myratmyradov1997/dowel-desk-shelf/source/README.md

# Sources

## Fusion 360 scripts (`fusion/`)

Everything is generated by Fusion 360 API scripts (Python). Run them from *Utilities → Add-Ins → Scripts*.
Before running, change the `OUT` path at the top of each script (it points to the author's machine as `/Users/YOU/...`).

| Script | Builds |
|---|---|
| `deskshelf_v2_4c.py` | The whole shelf: legs, tiles, drawers, clips, gauge, test coupons, interference and drawer-travel checks, STL/STEP/F3D export. Parameters at the top: rod positions `YS`, end-leg socket `R`, inner sockets `SOCK_INNER`, clip bore `CLIP_RI`, drawer and channel sizes. Without an open `balka` document the rods are built as D20 × 1100 cylinders. |
| `deskshelf_v2_5c.py` | **Current.** As v2.4c, plus wrap-around deck tiles (v2.5, experimental) and the drawer stop tongue rooted in the floor (v2.5c, `TG_*` parameters). |
| `print_ready_v2_4c.py`, `print_ready_v2_5c.py` | Turn the exported STL into print orientation (plain Python + numpy). |
| `deskshelf_modules_v2.py`, `deskshelf_modules_v2_on_v2_3.py`, `print_ready_modules_v2.py` | MacBook dock, bookend, Mac mini stand. |
| `magsafe_mount_v3.py`, `magsafe_v3_print_ready.py` | MagSafe mount with printed M8 screw. |
| `accessories/*` | Gridfinity, front-rod holders, storage, backlight. They import an assembly `.f3d` (see `SRC` at the top) — point it to a file in `../cad`. |

Coordinates (mm): x along the rods (−550…550), y front (−) to back (+), z up from the desk; rod axes at z = 105, y = −100/−50/0/50/100.

## OrcaSlicer (`orca/`)

`slice_plates.py PROFILE_DIR OUT_DIR plates.json` slices plates with the OrcaSlicer CLI using the flattened profiles
`abs_quality`, `abs_fast_020`, `abs_fast_028`, `abs_fast_028_tile` (FlyingBear Ghost 6, ABS). Import the JSON files into Orca or copy the values.
