myratmyradov1997/dowel-desk-shelf/images/all_in_one.png

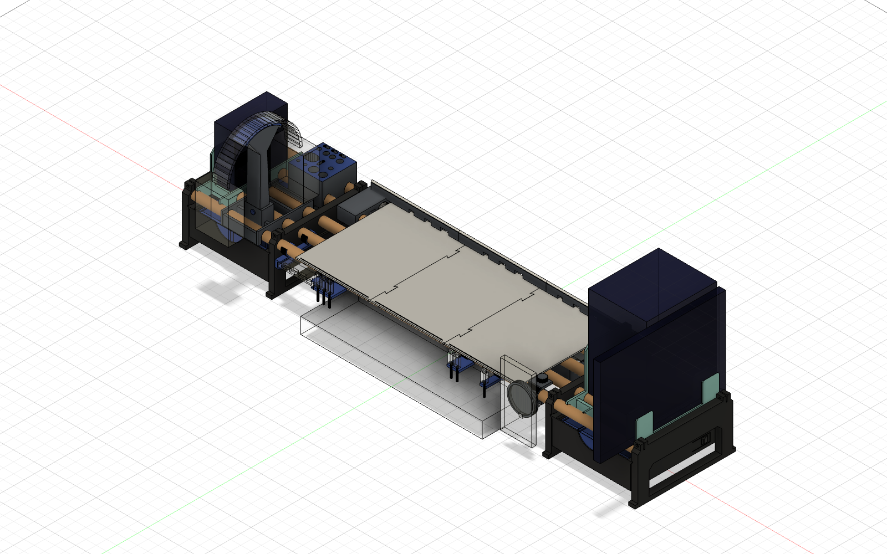
images/all_in_one.png
