myratmyradov1997/dowel-desk-shelf/images/shelf_closed.png

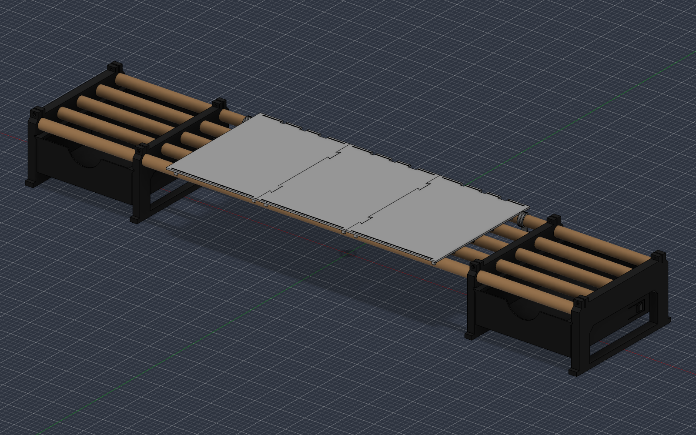
images/shelf_closed.png
