myratmyradov1997/dowel-desk-shelf/images/shelf_front.png

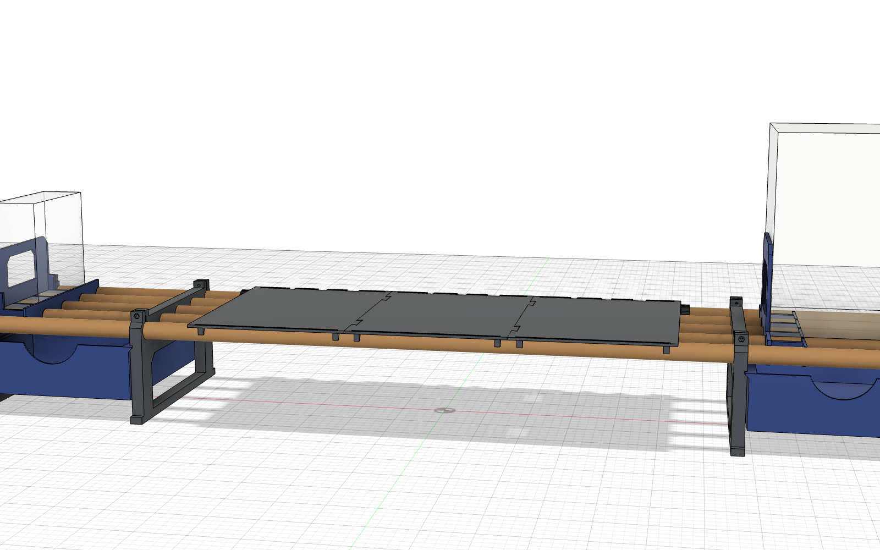
images/shelf_front.png
