myratmyradov1997/dowel-desk-shelf/cad/shelf_v2_5c_solids.step

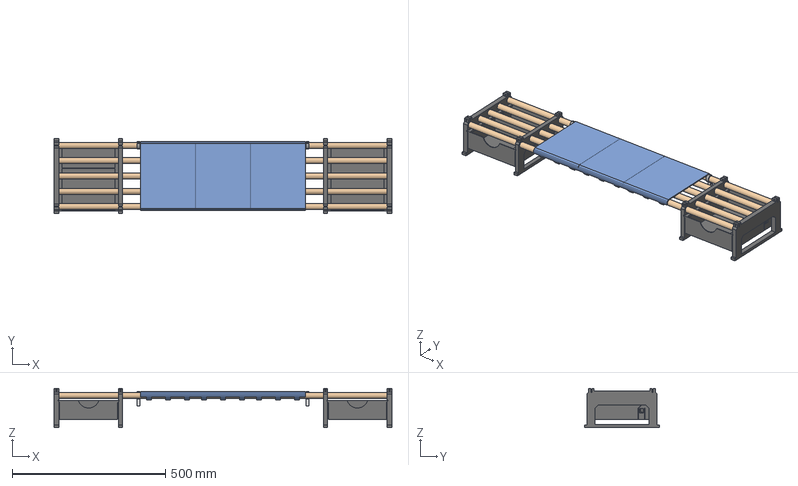
[picture p18: CAD file, 2026-10-23]
cad/shelf_v2_5c_solids.step
1104.0 x 244.0 x 128.0 mm
