myratmyradov1997/dowel-desk-shelf/stl/00-test-prints/fit_coupon_slide_drawer.stl

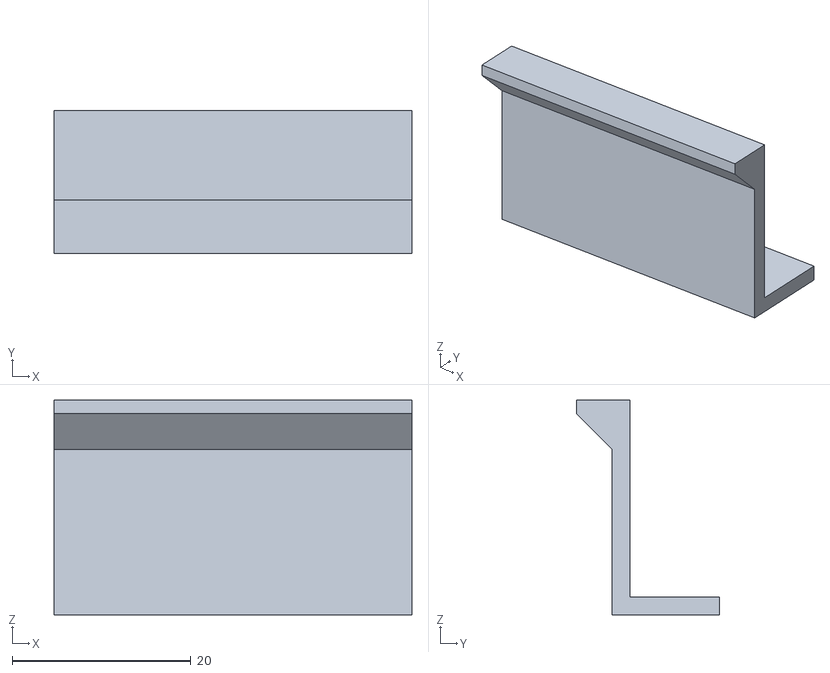
[picture p19: CAD file, 2026-10-20]
stl/00-test-prints/fit_coupon_slide_drawer.stl
40.0 x 16.0 x 24.0
