myratmyradov1997/dowel-desk-shelf/stl/01-shelf/drawer_left.stl

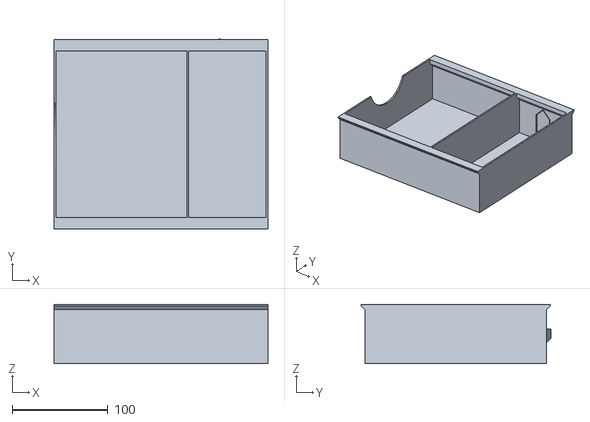
[picture p20: CAD file, 2026-10-23]
stl/01-shelf/drawer_left.stl
224.0 x 198.5 x 62.0
