myratmyradov1997/dowel-desk-shelf/stl/02-modules/bookend.stl

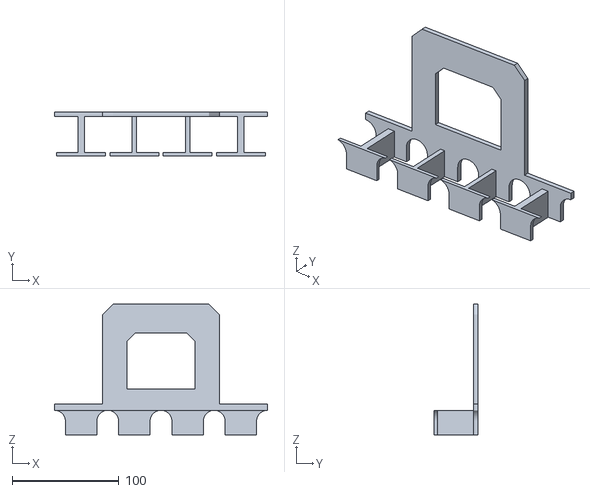
[picture p21: CAD file, 2026-10-20]
stl/02-modules/bookend.stl
200.0 x 41.0 x 123.0
