myratmyradov1997/dowel-desk-shelf/stl/03-magsafe/magsafe_mount_v3.stl

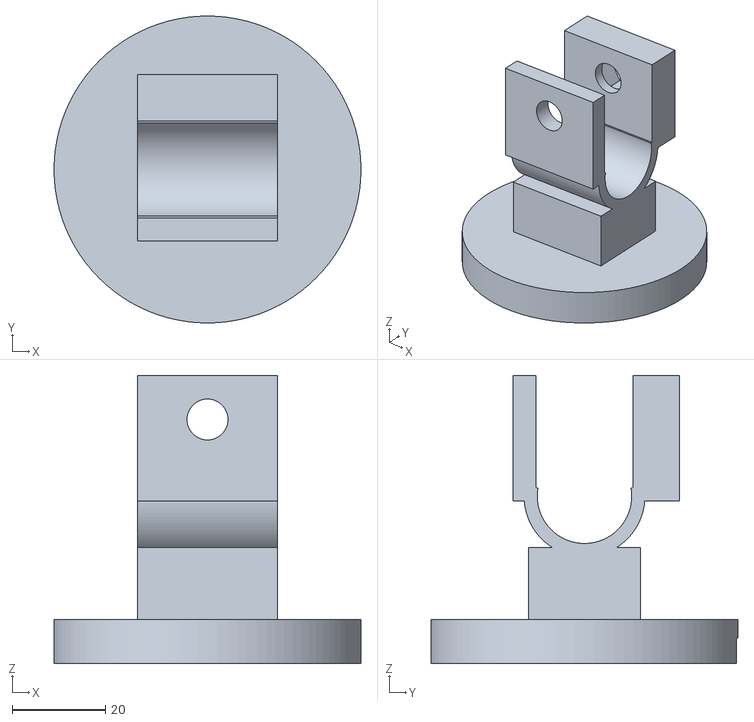
[picture p22: CAD file, 2026-10-20]
stl/03-magsafe/magsafe_mount_v3.stl
66.0 x 66.0 x 62.0
