myratmyradov1997/dowel-desk-shelf/stl/04-gridfinity/gf_bin_2x2_7u.stl

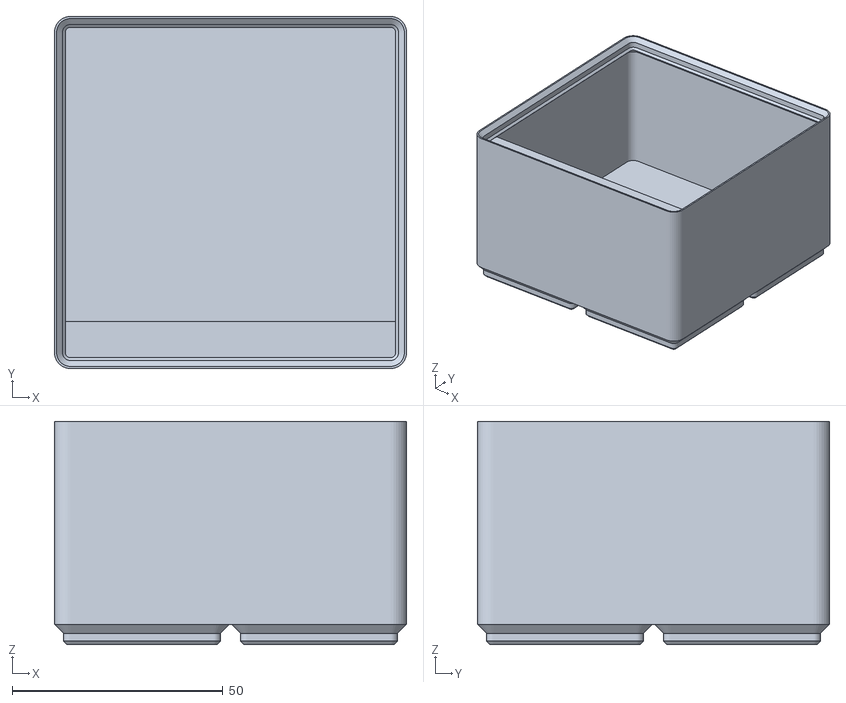
[picture p23: CAD file, 2026-10-20]
stl/04-gridfinity/gf_bin_2x2_7u.stl
83.5 x 83.5 x 52.9
