myratmyradov1997/dowel-desk-shelf/stl/06-storage/tool_rail.stl

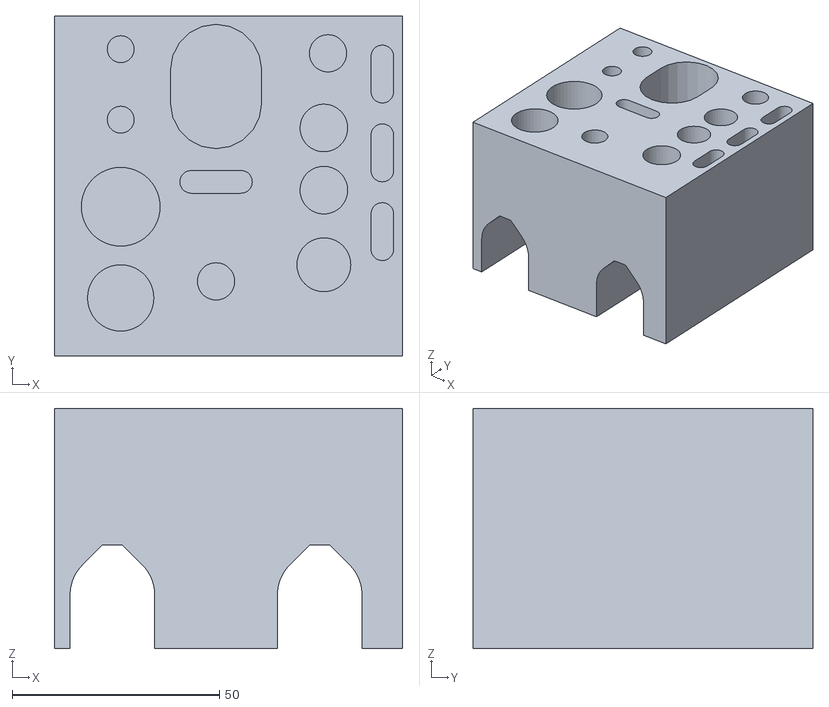
[picture p25: CAD file, 2026-10-20]
stl/06-storage/tool_rail.stl
84.0 x 82.0 x 58.0
