myratmyradov1997/dowel-desk-shelf/stl/07-backlight/acc_backlight_diffuser_S2.stl

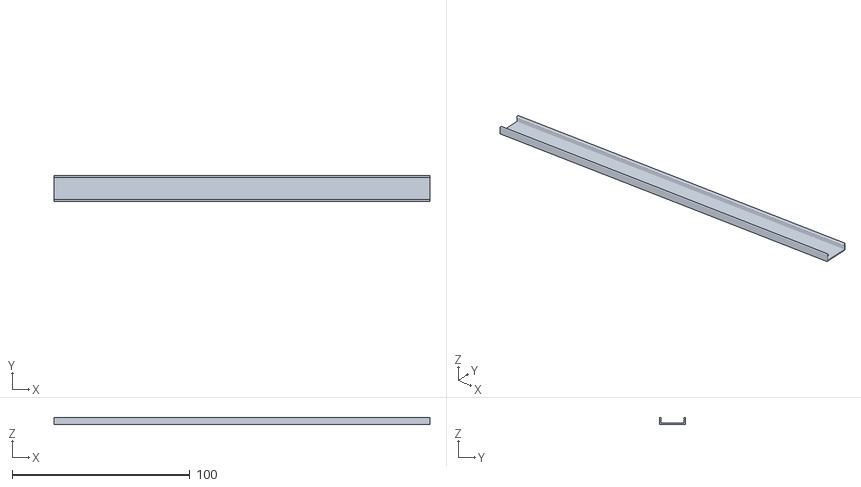
[picture p26: CAD file, 2026-10-20]
stl/07-backlight/acc_backlight_diffuser_S2.stl
211.8 x 14.9 x 4.05
