myratmyradov1997/dowel-desk-shelf/stl/00-test-prints/fit_coupon_slide_leg.stl

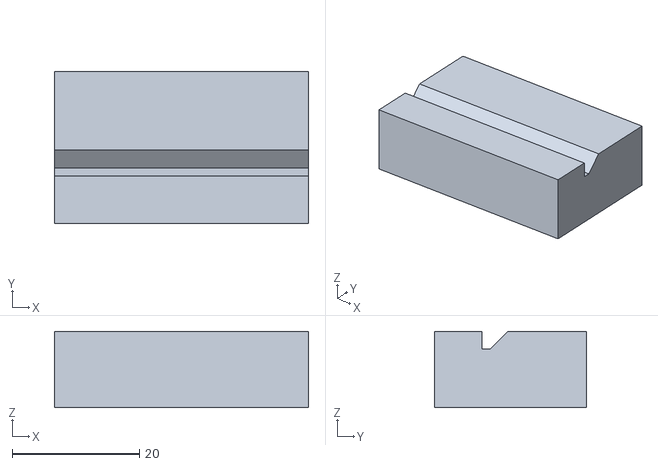
[picture p27: CAD file, 2026-10-20]
stl/00-test-prints/fit_coupon_slide_leg.stl
40.0 x 24.0 x 12.0
