myratmyradov1997/dowel-desk-shelf/stl/01-shelf/deck_tile_wrap_v2.5.stl

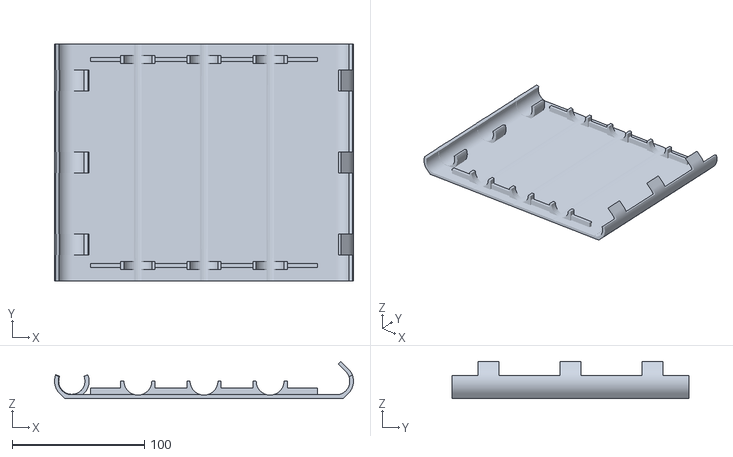
[picture p28: CAD file, 2026-10-23]
stl/01-shelf/deck_tile_wrap_v2.5.stl
226.2 x 179.5 x 28.0
