myratmyradov1997/dowel-desk-shelf/stl/02-modules/macmini_stand.stl

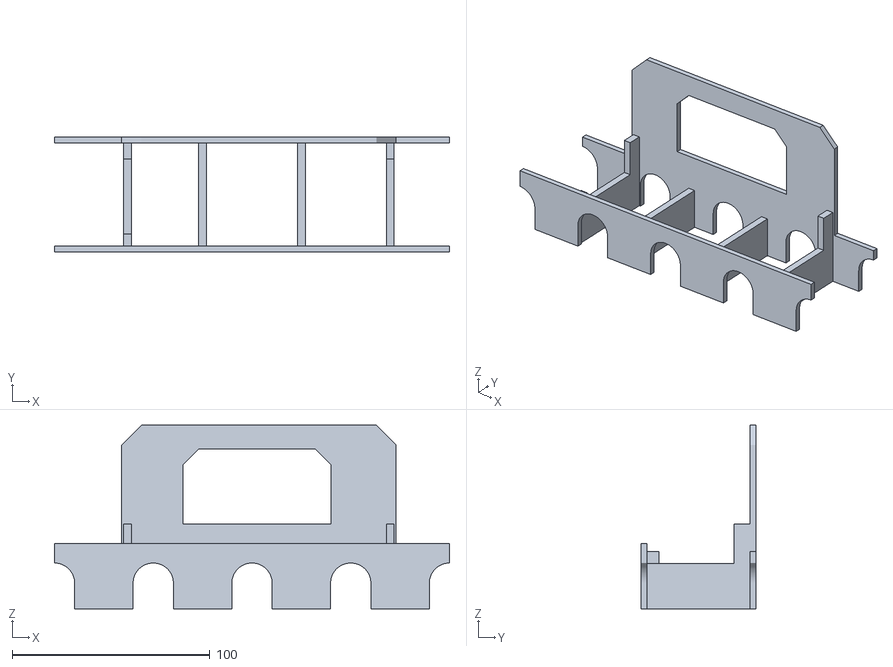
[picture p29: CAD file, 2026-10-20]
stl/02-modules/macmini_stand.stl
200.0 x 58.0 x 93.0
