myratmyradov1997/dowel-desk-shelf/stl/04-gridfinity/gf_bin_1x3_7u_dupont.stl

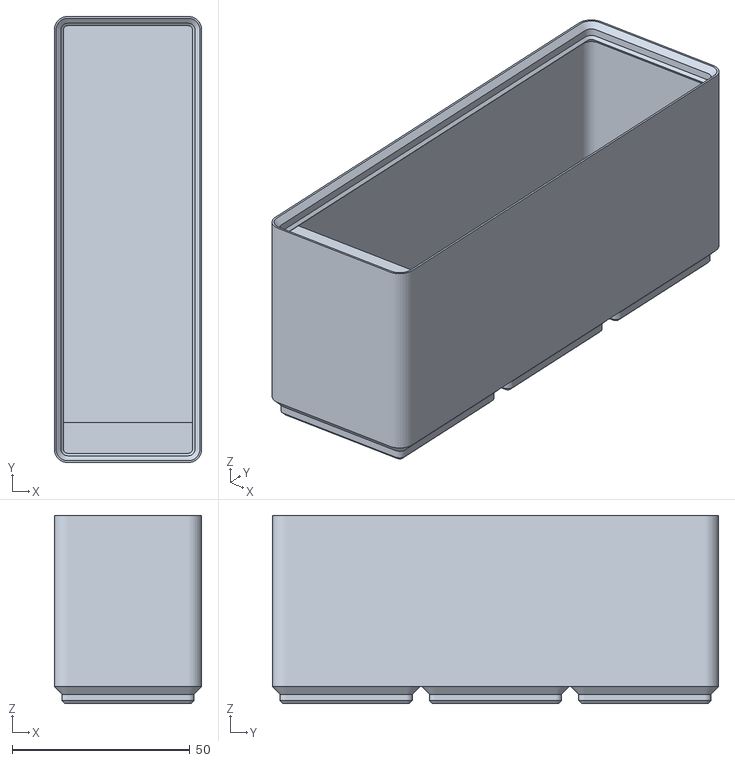
[picture p30: CAD file, 2026-10-20]
stl/04-gridfinity/gf_bin_1x3_7u_dupont.stl
41.5 x 125.5 x 52.9
