myratmyradov1997/dowel-desk-shelf/stl/05-front-rod/acc_cable_clip_2.stl

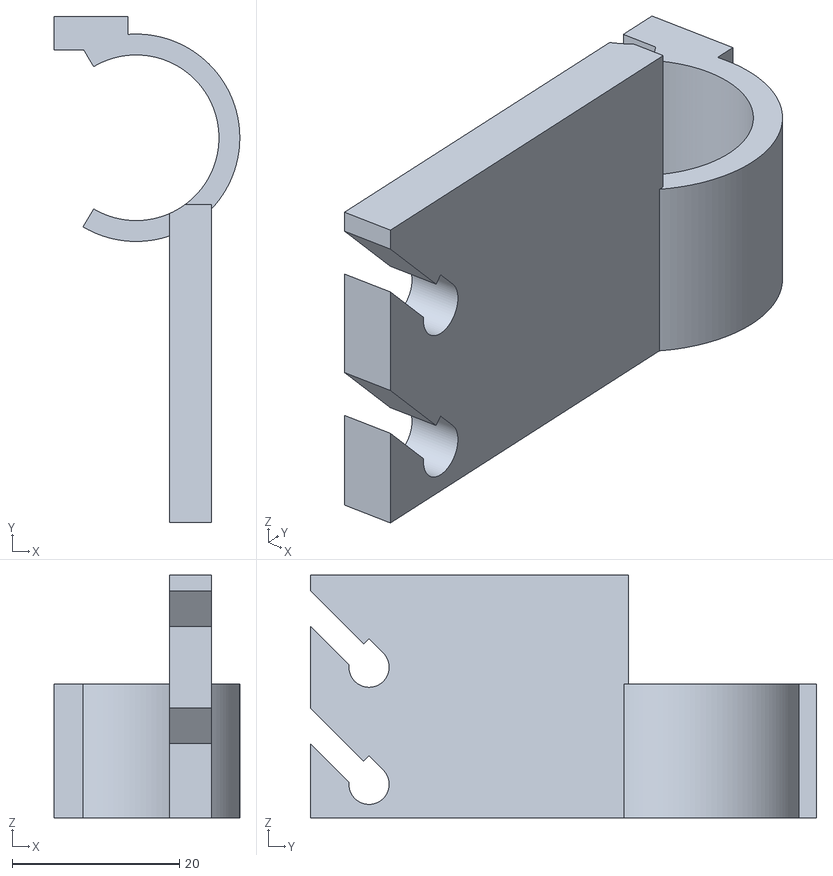
[picture p31: CAD file, 2026-10-20]
stl/05-front-rod/acc_cable_clip_2.stl
22.2 x 60.5 x 29.0
