myratmyradov1997/dowel-desk-shelf/stl/06-storage/tray_end_R.stl

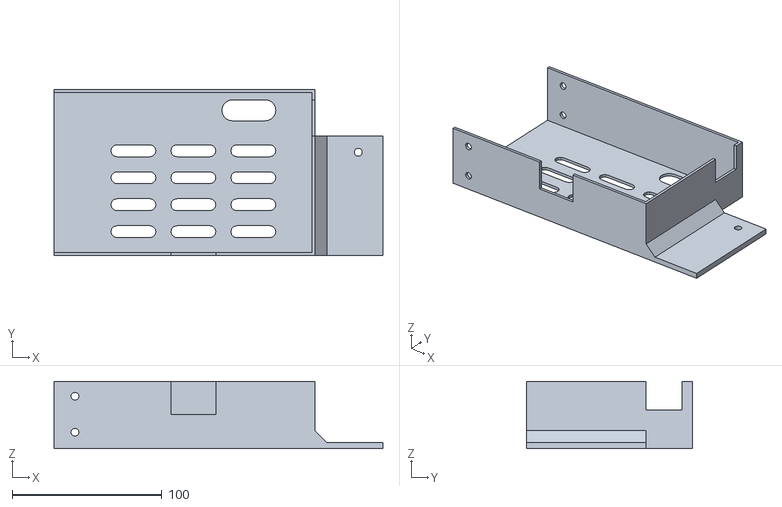
[picture p32: CAD file, 2026-10-20]
stl/06-storage/tray_end_R.stl
219.5 x 111.0 x 45.0
