myratmyradov1997/dowel-desk-shelf/stl/07-backlight/acc_backlight_box.stl

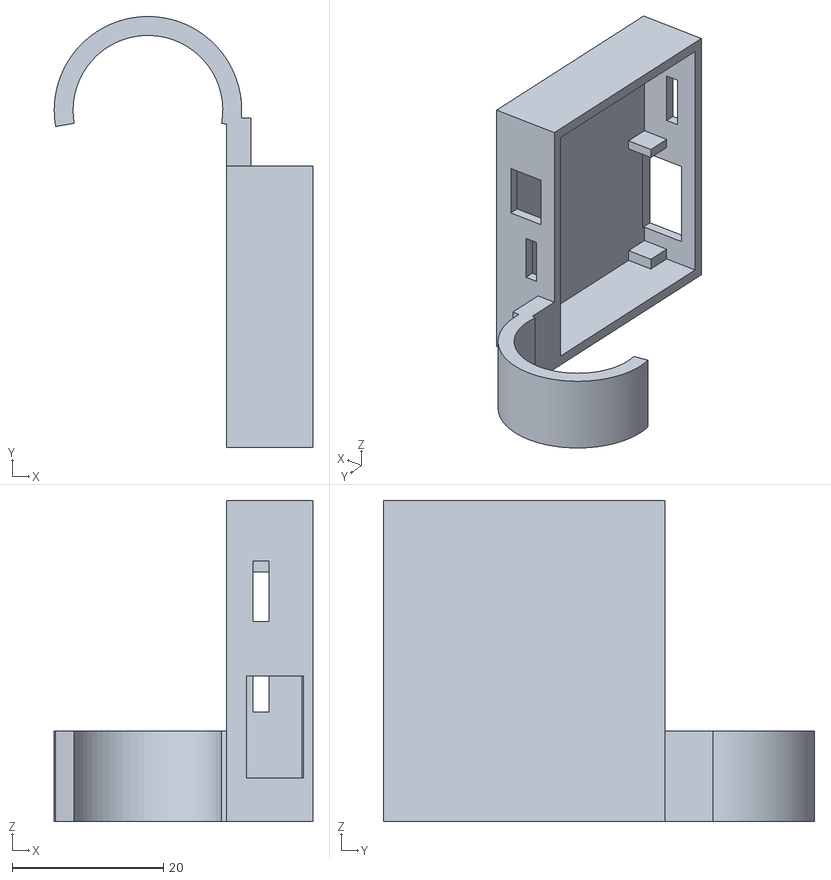
[picture p33: CAD file, 2026-10-20]
stl/07-backlight/acc_backlight_box.stl
34.2 x 57.0 x 42.5
