myratmyradov1997/dowel-desk-shelf/stl/00-test-prints/fit_coupon_sockets.stl

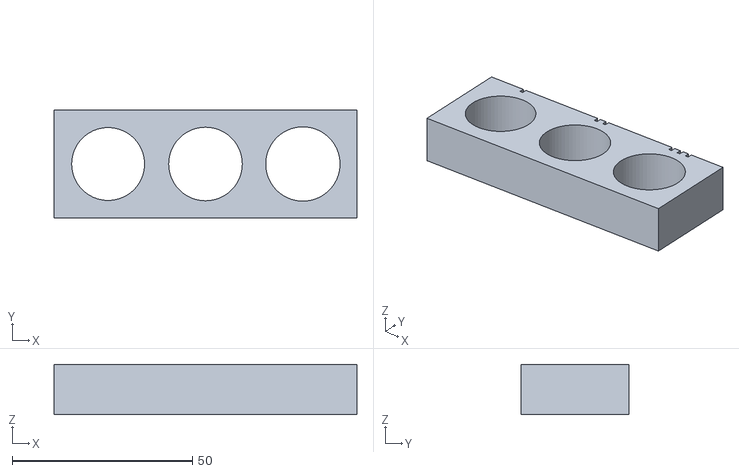
[picture p34: CAD file, 2026-10-20]
stl/00-test-prints/fit_coupon_sockets.stl
84.0 x 30.0 x 14.0
