myratmyradov1997/dowel-desk-shelf/stl/01-shelf/drawer_right.stl

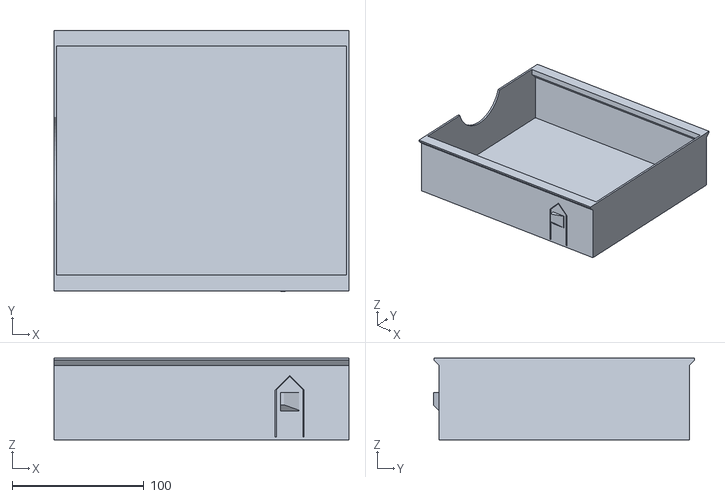
[picture p35: CAD file, 2026-10-23]
stl/01-shelf/drawer_right.stl
224.0 x 198.5 x 62.0
