myratmyradov1997/dowel-desk-shelf/stl/02-modules/laptop_dock.stl

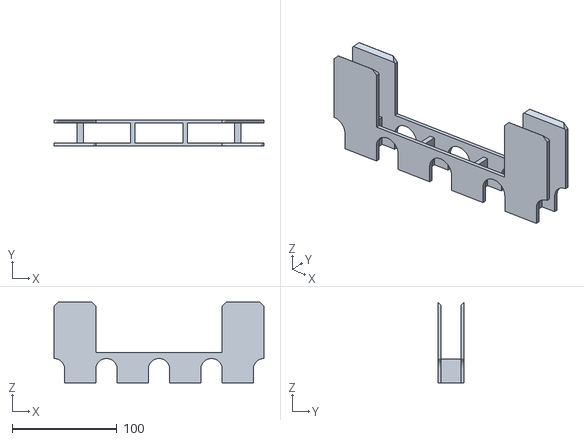
[picture p36: CAD file, 2026-10-20]
stl/02-modules/laptop_dock.stl
200.0 x 25.0 x 77.0
