myratmyradov1997/dowel-desk-shelf/stl/05-front-rod/acc_hub_cap_right.stl

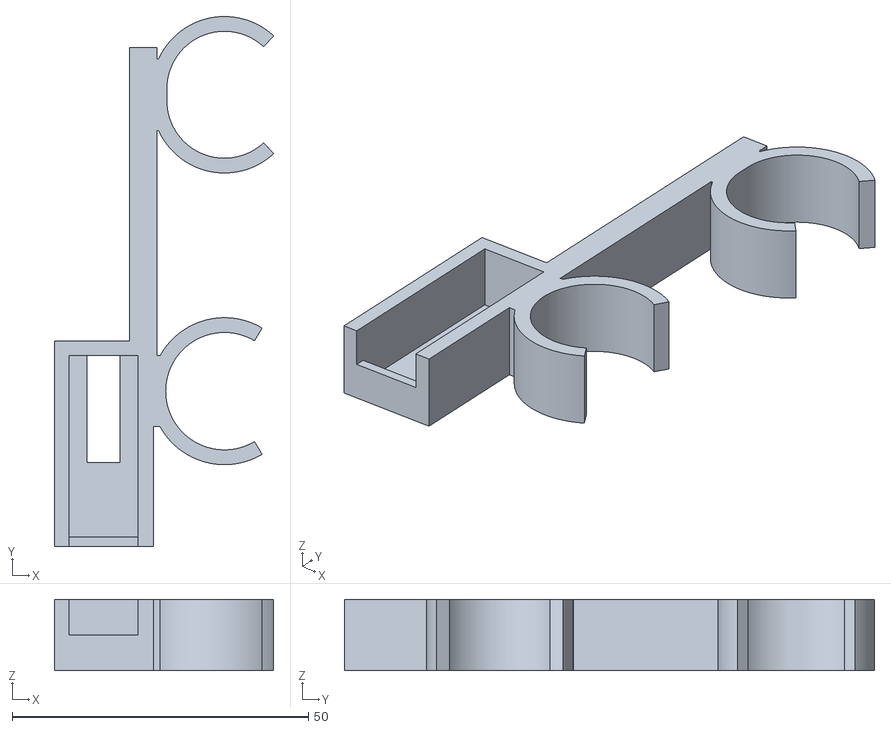
[picture p38: CAD file, 2026-10-20]
stl/05-front-rod/acc_hub_cap_right.stl
37.0 x 89.4 x 12.0
