myratmyradov1997/dowel-desk-shelf/stl/06-storage/tray_hanger_L.stl

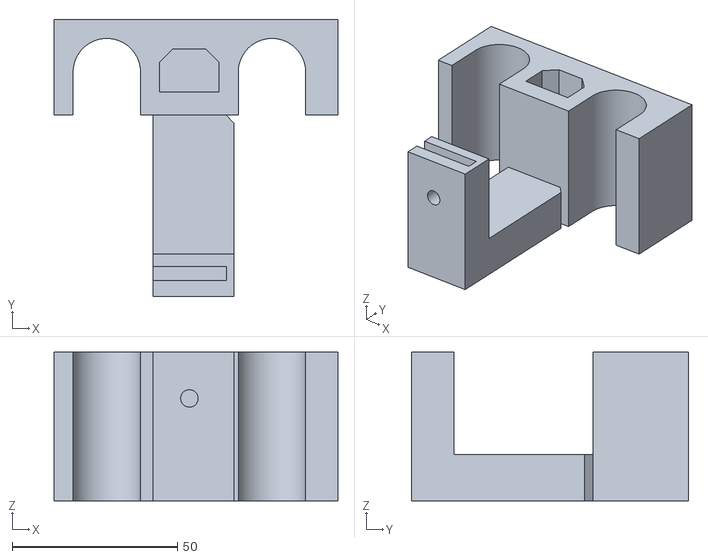
[picture p39: CAD file, 2026-10-20]
stl/06-storage/tray_hanger_L.stl
86.0 x 84.0 x 45.0
