myratmyradov1997/dowel-desk-shelf/stl/07-backlight/acc_backlight_rail_S1.stl

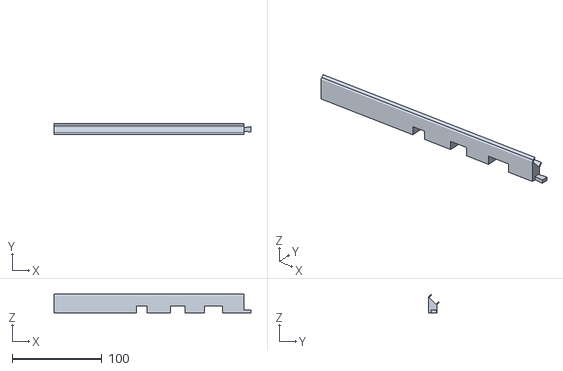
[picture p40: CAD file, 2026-10-20]
stl/07-backlight/acc_backlight_rail_S1.stl
219.9 x 12.0 x 20.8
