myratmyradov1997/dowel-desk-shelf/stl/01-shelf/leg_end_left_D20.4.stl

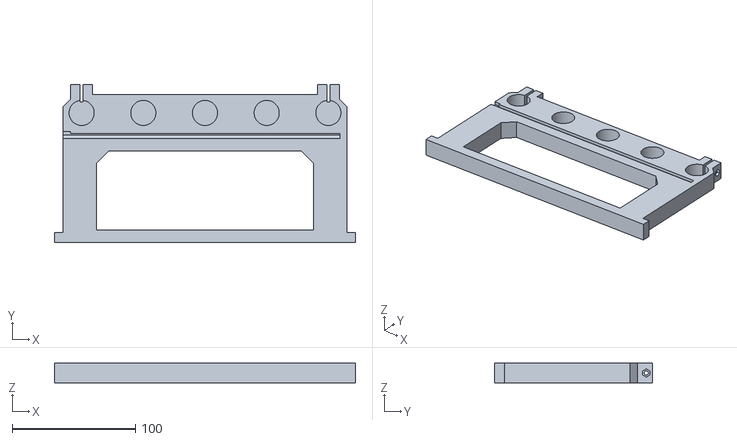
[picture p41: CAD file, 2026-10-20]
stl/01-shelf/leg_end_left_D20.4.stl
244.0 x 128.0 x 16.0
