myratmyradov1997/dowel-desk-shelf/stl/04-gridfinity/gf_plate_R_half_2x5.stl

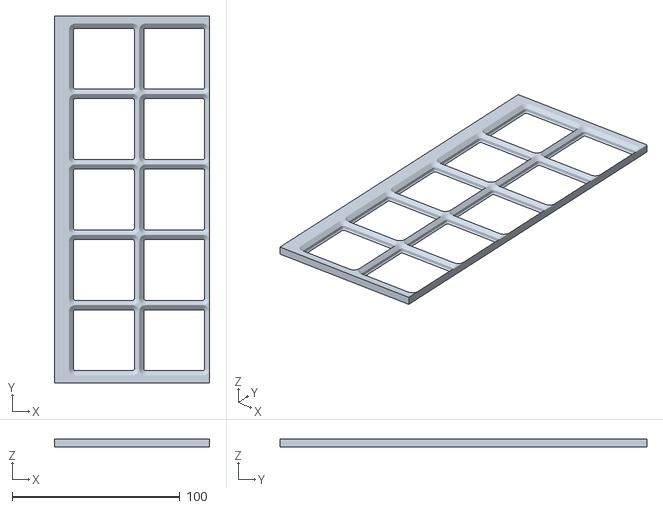
[picture p42: CAD file, 2026-10-20]
stl/04-gridfinity/gf_plate_R_half_2x5.stl
92.5 x 219.0 x 4.60
