myratmyradov1997/dowel-desk-shelf/stl/05-front-rod/acc_cable_clip_3.stl

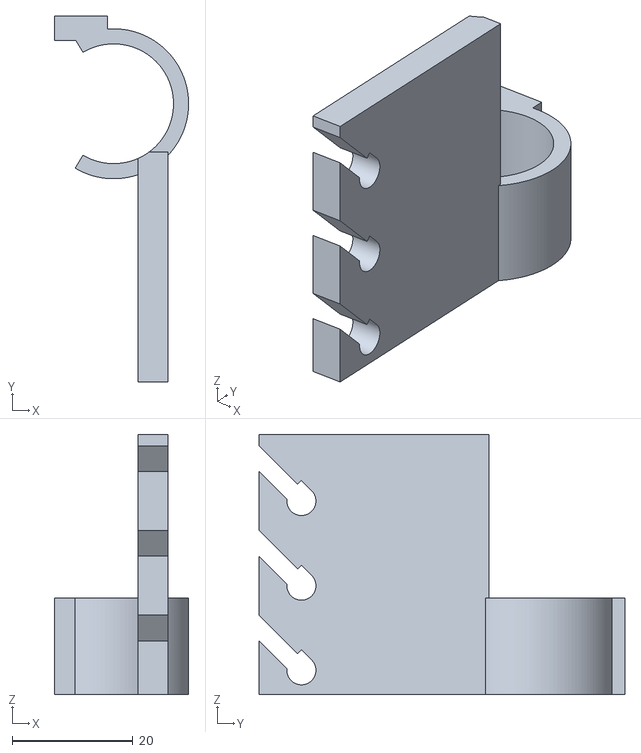
[picture p43: CAD file, 2026-10-20]
stl/05-front-rod/acc_cable_clip_3.stl
22.2 x 60.5 x 43.0
