myratmyradov1997/dowel-desk-shelf/stl/06-storage/hp_foot.stl

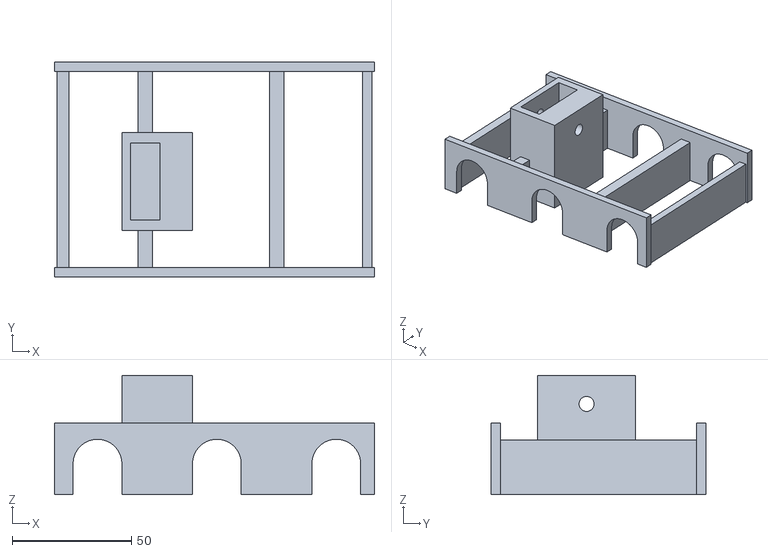
[picture p44: CAD file, 2026-10-20]
stl/06-storage/hp_foot.stl
134.0 x 90.0 x 50.0
