myratmyradov1997/dowel-desk-shelf/stl/04-gridfinity/gf_plate_Lback_half_2x1.stl

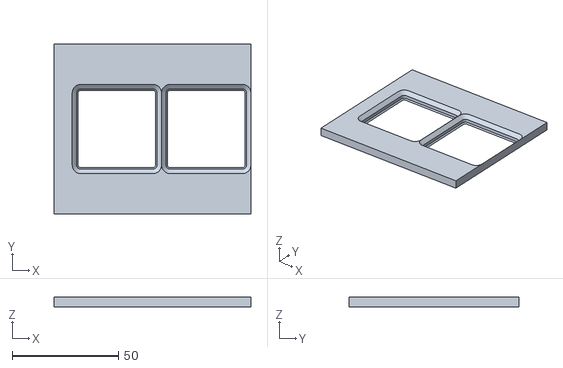
[picture p45: CAD file, 2026-10-20]
stl/04-gridfinity/gf_plate_Lback_half_2x1.stl
92.5 x 80.0 x 4.60
