myratmyradov1997/dowel-desk-shelf/stl/06-storage/hp_pin.stl

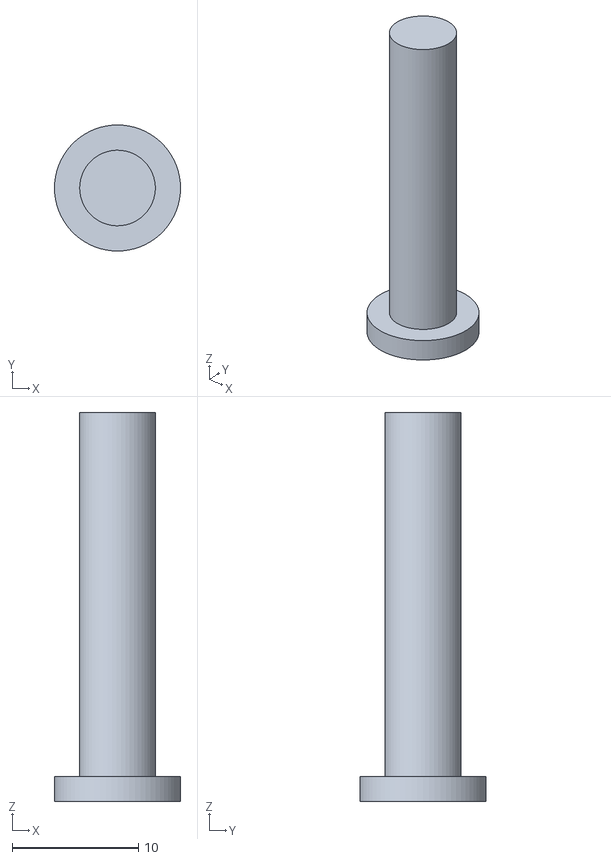
[picture p46: CAD file, 2026-10-20]
stl/06-storage/hp_pin.stl
10.0 x 10.0 x 30.8
