myratmyradov1997/dowel-desk-shelf/stl/07-backlight/acc_backlight_rail_S2.stl

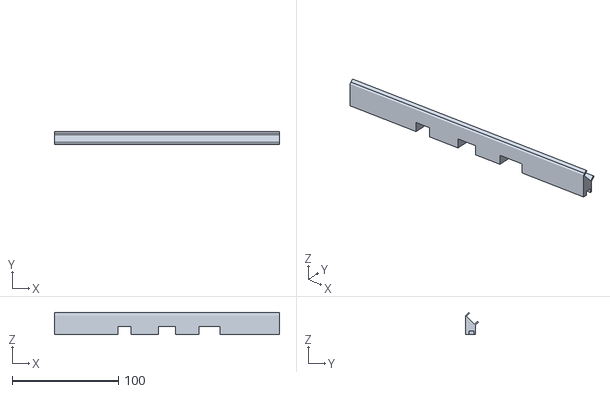
[picture p47: CAD file, 2026-10-20]
stl/07-backlight/acc_backlight_rail_S2.stl
211.8 x 12.0 x 20.8
