myratmyradov1997/dowel-desk-shelf/stl/04-gridfinity/gf_plate_Lfront_half_2x3.stl

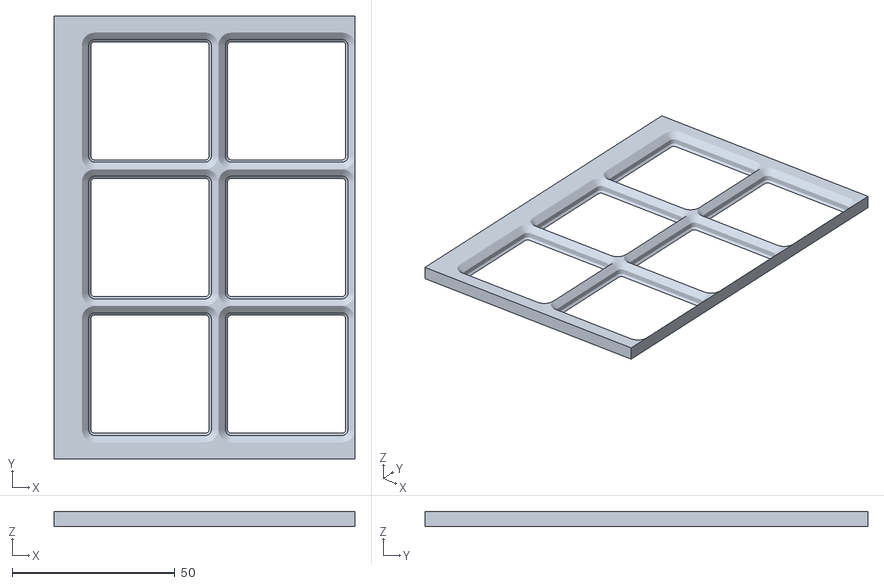
[picture p49: CAD file, 2026-10-20]
stl/04-gridfinity/gf_plate_Lfront_half_2x3.stl
92.5 x 136.0 x 4.60
