myratmyradov1997/dowel-desk-shelf/stl/07-backlight/acc_backlight_bracket_L.stl

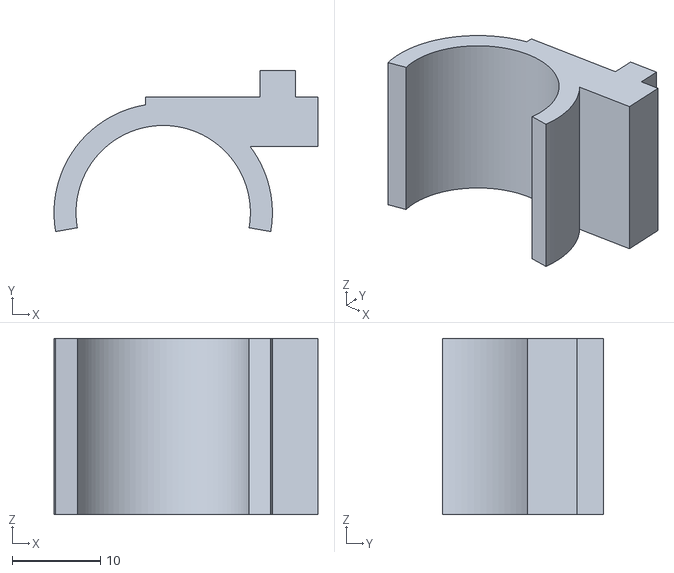
[picture p50: CAD file, 2026-10-20]
stl/07-backlight/acc_backlight_bracket_L.stl
30.0 x 18.3 x 20.0
