myratmyradov1997/dowel-desk-shelf/stl/01-shelf/deck_tile_2.stl

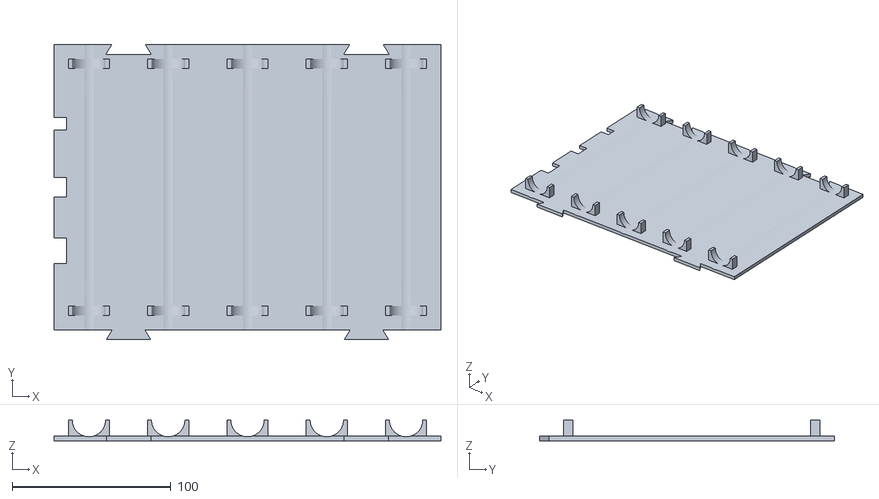
[picture p51: CAD file, 2026-10-20]
stl/01-shelf/deck_tile_2.stl
244.0 x 186.0 x 13.1
