myratmyradov1997/dowel-desk-shelf/stl/04-gridfinity/gf_bin_1x1_7u.stl

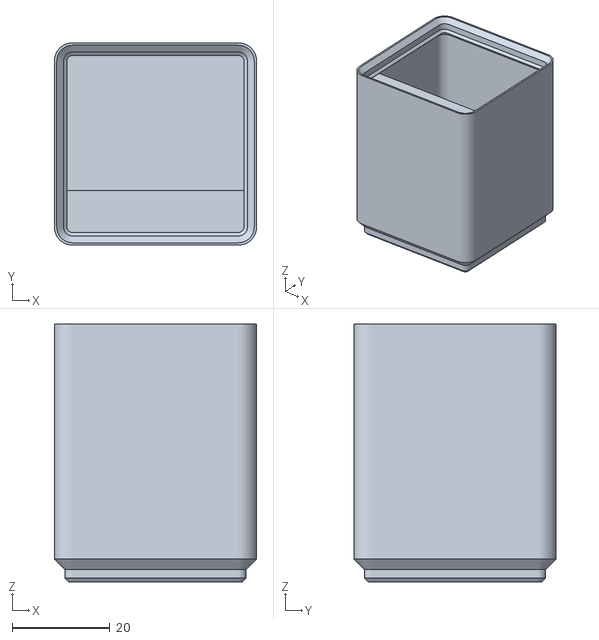
[picture p52: CAD file, 2026-10-20]
stl/04-gridfinity/gf_bin_1x1_7u.stl
41.5 x 41.5 x 52.9
