myratmyradov1997/dowel-desk-shelf/stl/06-storage/tray_lock_pin.stl

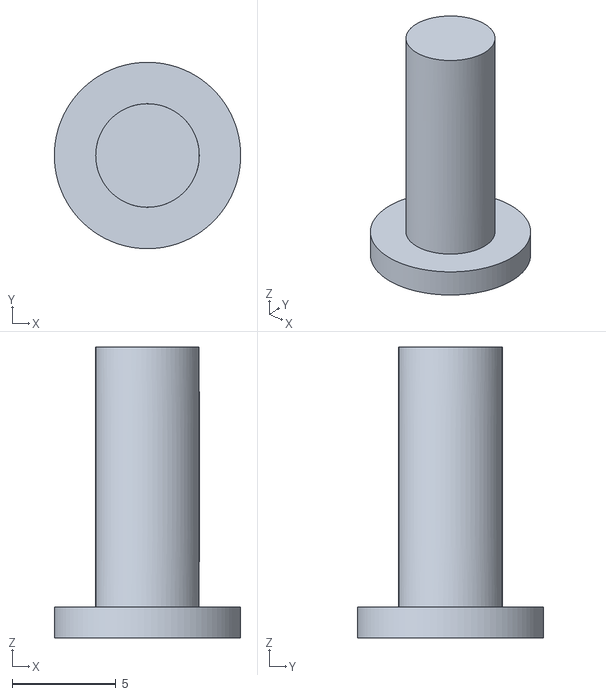
[picture p53: CAD file, 2026-10-20]
stl/06-storage/tray_lock_pin.stl
9.00 x 8.99 x 14.0
