myratmyradov1997/dowel-desk-shelf/stl/07-backlight/acc_backlight_box_lid.stl

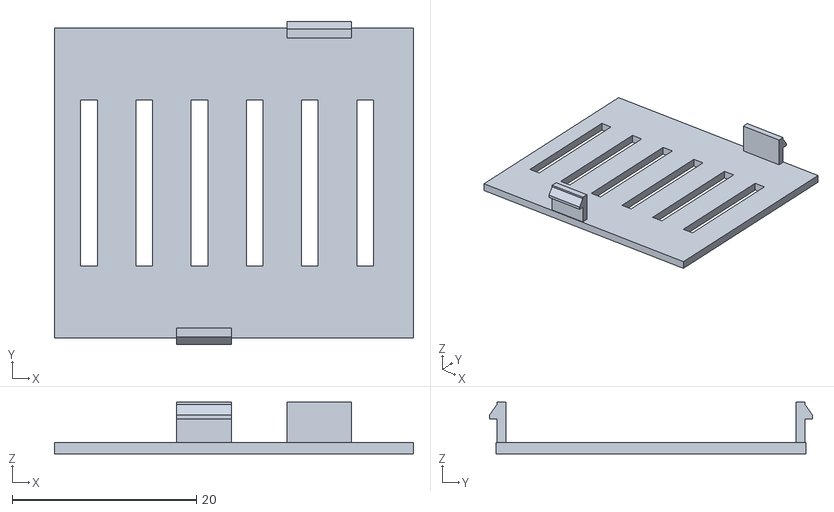
[picture p54: CAD file, 2026-10-20]
stl/07-backlight/acc_backlight_box_lid.stl
39.0 x 35.1 x 5.60
