myratmyradov1997/dowel-desk-shelf/stl/01-shelf/bay_gauge.stl

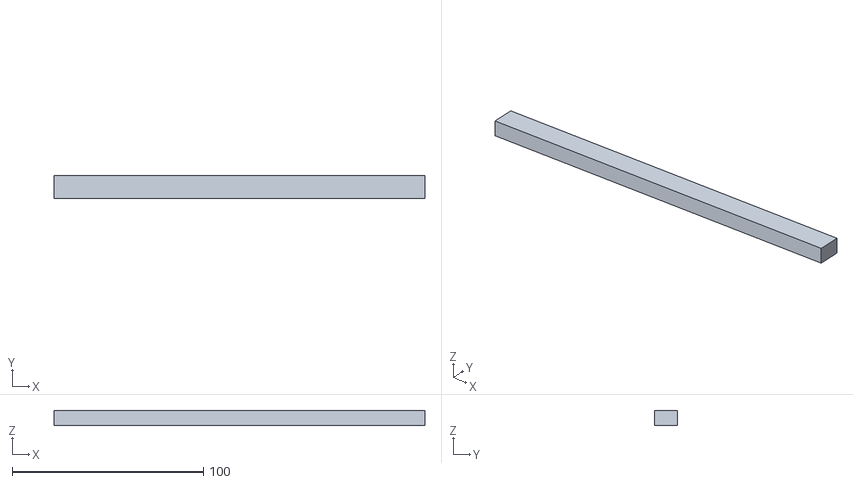
[picture p55: CAD file, 2026-10-20]
stl/01-shelf/bay_gauge.stl
194.0 x 12.0 x 8.00
