myratmyradov1997/dowel-desk-shelf/stl/07-backlight/acc_backlight_bracket_R.stl

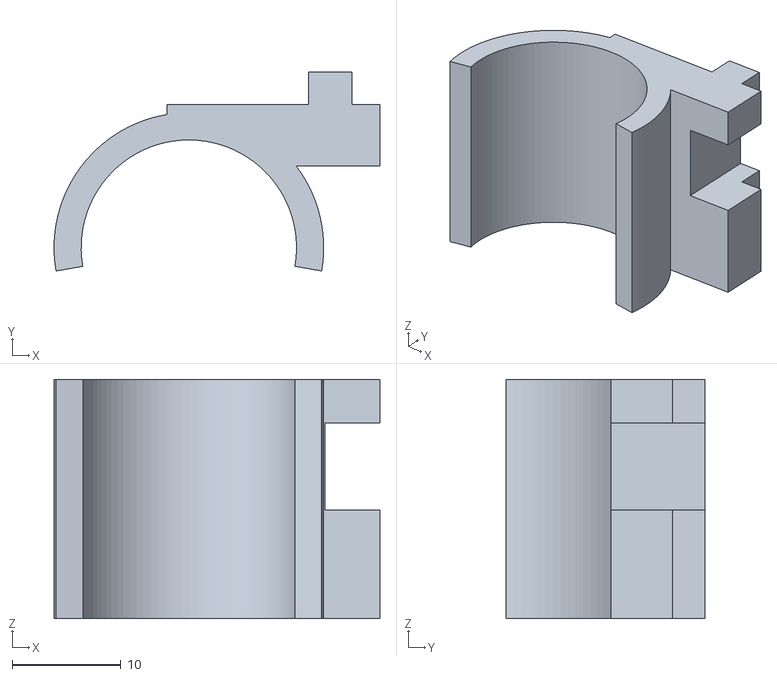
[picture p56: CAD file, 2026-10-20]
stl/07-backlight/acc_backlight_bracket_R.stl
30.0 x 18.3 x 22.0
