myratmyradov1997/dowel-desk-shelf/stl/06-storage/hp_post.stl

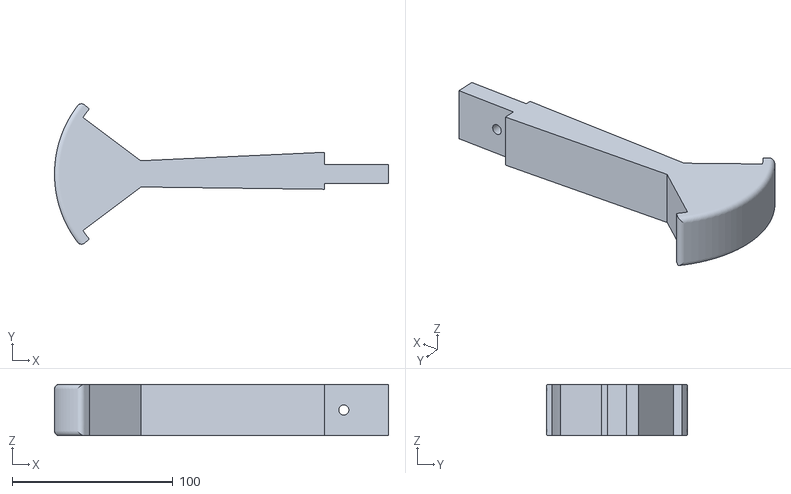
[picture p57: CAD file, 2026-10-20]
stl/06-storage/hp_post.stl
207.8 x 87.5 x 32.0
