myratmyradov1997/dowel-desk-shelf/stl/01-shelf/leg_inner_left_fitted_20.2-19.3-20.4-19.3-20.2.stl

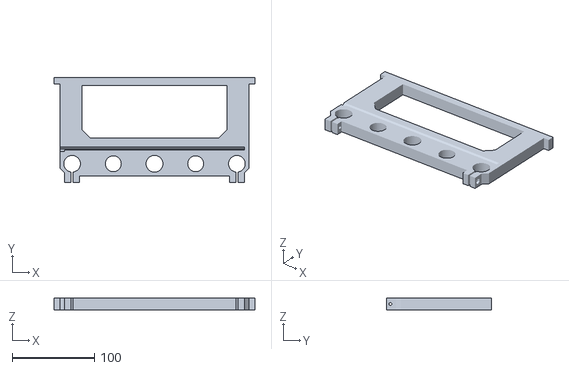
[picture p58: CAD file, 2026-10-20]
stl/01-shelf/leg_inner_left_fitted_20.2-19.3-20.4-19.3-20.2.stl
244.0 x 128.0 x 14.0
