myratmyradov1997/dowel-desk-shelf/stl/06-storage/tray_mid.stl

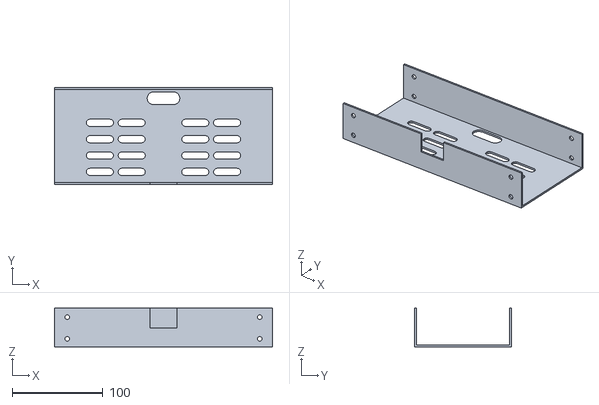
[picture p59: CAD file, 2026-10-20]
stl/06-storage/tray_mid.stl
240.0 x 106.4 x 42.9
