myratmyradov1997/dowel-desk-shelf/stl/01-shelf/rod_clip_D20.2.stl

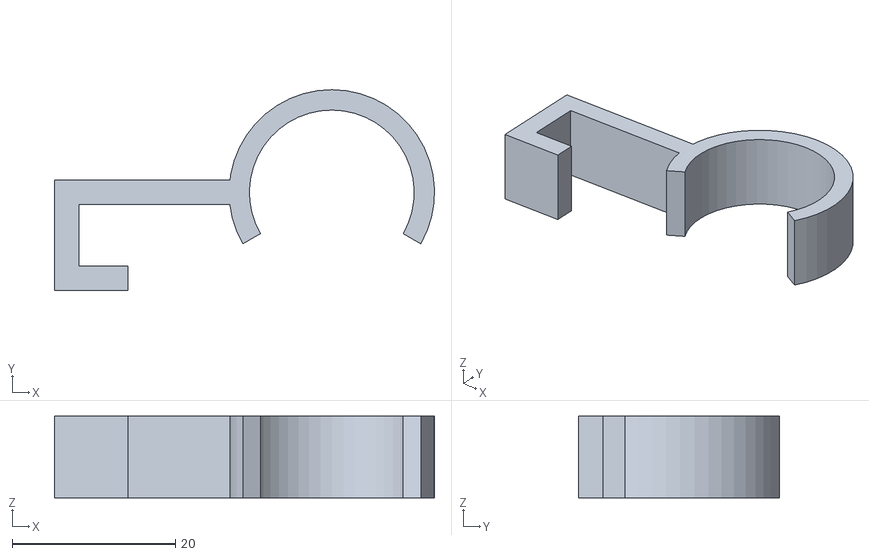
[picture p60: CAD file, 2026-10-20]
stl/01-shelf/rod_clip_D20.2.stl
46.6 x 24.6 x 10.0
