myratmyradov1997/dowel-desk-shelf/stl/06-storage/tray_pin.stl

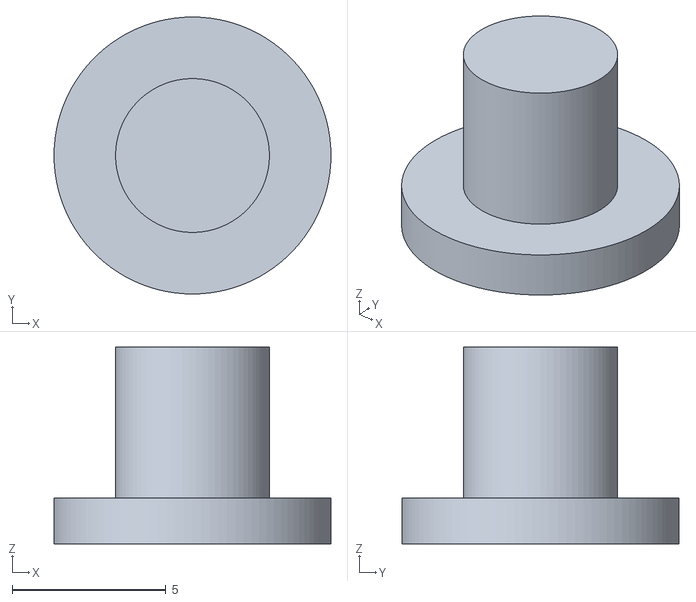
[picture p61: CAD file, 2026-10-20]
stl/06-storage/tray_pin.stl
9.00 x 9.00 x 6.40
