myratmyradov1997/dowel-desk-shelf/stl/01-shelf/rod_clip_D19.8.stl

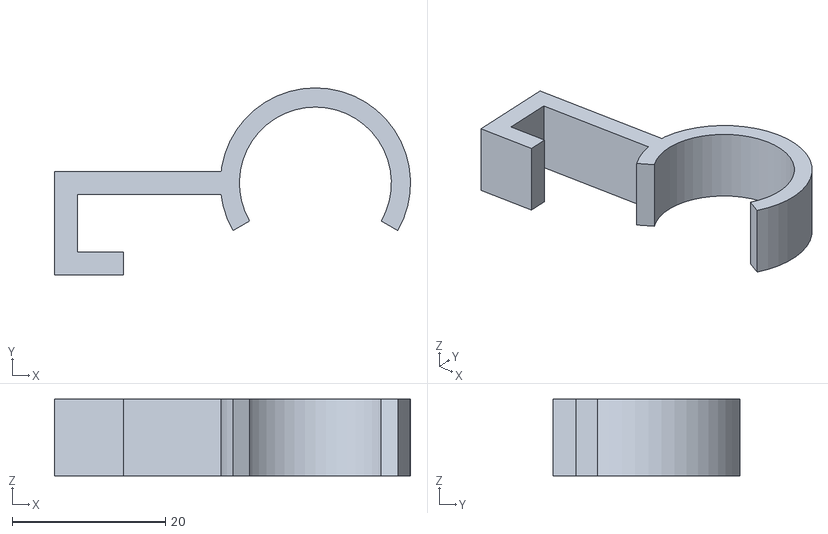
[picture p62: CAD file, 2026-10-20]
stl/01-shelf/rod_clip_D19.8.stl
46.4 x 24.4 x 10.0
