myratmyradov1997/dowel-desk-shelf/stl/01-shelf/deck_tile_1.stl

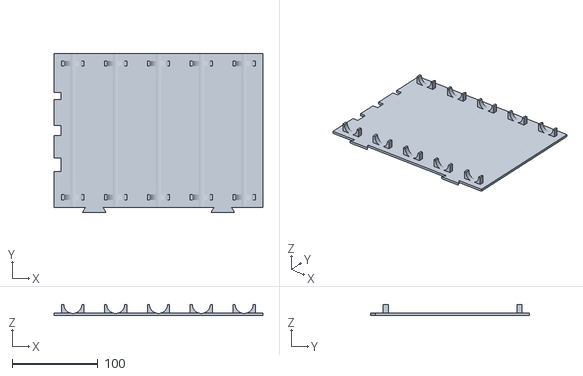
[picture p63: CAD file, 2026-10-20]
stl/01-shelf/deck_tile_1.stl
244.0 x 186.0 x 13.1
