myratmyradov1997/dowel-desk-shelf/stl/01-shelf/deck_tile_3.stl

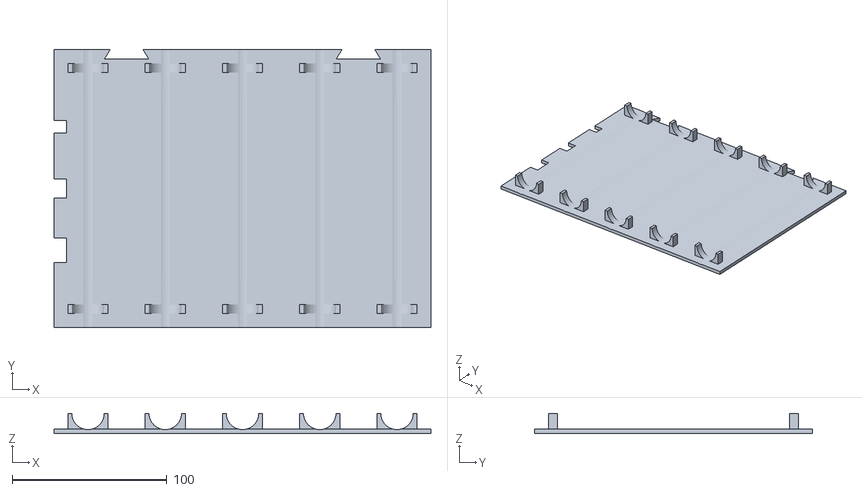
[picture p64: CAD file, 2026-10-20]
stl/01-shelf/deck_tile_3.stl
244.0 x 180.0 x 13.1
