myratmyradov1997/dowel-desk-shelf/(list of files, cad)

Other CAD files:
cad/shelf_v2_4c_solids.step
stl/07-backlight/acc_backlight_diffuser_S3.stl
stl/01-shelf/leg_end_right_D20.4.stl
stl/05-front-rod/acc_hub_cap_left.stl
stl/06-storage/tray_hanger_R.stl
stl/06-storage/tray_end_L.stl
stl/01-shelf/leg_inner_right_D20.4.stl
stl/07-backlight/acc_backlight_diffuser_S1.stl
stl/07-backlight/acc_backlight_rail_S3.stl
stl/01-shelf/leg_inner_right_fitted_20.2-19.3-20.4-19.3-20.2.stl
cad/acc_backlight.f3d
cad/acc_front_rod.f3d
cad/acc_gridfinity.f3d
cad/acc_storage.f3d
cad/all_in_one.f3d
cad/magsafe_v3_on_shelf.f3d
cad/shelf_v2_4c.f3d
cad/shelf_v2_5c.f3d
cad/shelf_with_modules.f3d
stl/03-magsafe/magsafe_v3_nut.stl
stl/03-magsafe/magsafe_v3_screw.stl
