myratmyradov1997/dowel-desk-shelf/docs/assembly_visual_ru.html

# Сборка полки на пяти прутках

Восемь шагов, которые стоит сделать при сборке, чтобы ящики ходили ровно, а полка не шаталась. Рисунки схематичные, зазоры и изгибы показаны крупнее, чем на самом деле.

хороший пруток ≈20.0–20.1 мм тонкий пруток ≈19.0 мм пепельные детали синие детали

ШАГ 1

## Расставь прутки: тонкие на 2-е и 4-е места

- 1, 3, 5: три хороших прутка. На 1-м и 5-м стоят хомуты с винтами, они держат опоры на месте. Поэтому там нужны прутки, которые хомут реально зажмёт.
- 2 и 4: тонкие. Хомутов там нет, прутки просто несут плитку.
- Хомут сжимается максимум до ~19.6 мм, тонкий пруток 19.0 он не зажмёт, как ни тяни.

ШАГ 2

## Подготовь прутки до сборки

- Бугры сними наждачкой. Внутренняя опора должна проехать по пруту 20–33 см без заеданий.
- Кольцо D20.2 из старого пробника прогони по каждому хорошему пруту.
- Парафин: натри обычной свечкой участки, по которым едет опора. Скользит заметно легче.
- Номер напиши карандашом на торцах: «1Л / 1П … 5Л / 5П». При разборке прутки встанут на те же места.

ШАГ 3

## Найди горб и поверни пруток горбом вниз

Как найти горб: положи пруток на ровный пол и покатай. Он остановится горбом вверх. Отметь эту сторону карандашом, а при сборке поверни её вниз. Если горб смотрит вбок, опоры встанут криво, и паз под ящик тоже.

ШАГ 4

## Тонкие прутки в крайних опорах: термоусадка или изолента

- Наматывай, пока пруток не войдёт в гнездо с усилием. Обычно 4–5 витков.
- Ещё лучше клеевая термоусадка на конец: она не ползёт.
- Клей только если не планируешь разбирать полку: эпоксидка или «Момент». ПВА к ABS не держит.
- Средний пруток 3 в крайних опорах при люфте — 1 виток.

ШАГ 5

## Разная длина: ставь каждый пруток по центру

Отметь середину каждого прутка и выставь их так, чтобы с обеих сторон в гнездо зашло поровну. Аккуратнее отпилить длинные по самому короткому ножовкой в стусле и снять фаску: тогда все прутки упираются в дно.

ШАГ 6

## Выставь внутреннюю опору бруском и затяни хомуты, когда ящик внутри

- Положи брусок на стол между опорами, вплотную к обеим, сначала спереди, потом сзади.
- Вставь ящик и только потом затяни винты M3 на хомутах внутренней опоры (передний и задний пруток).
- Брусок лежит у пола, а паз ящика на высоте 8 см. Если опора чуть наклонилась, по бруску этого не видно, а ящик сразу начнёт тереть.
- Проверь ход ящика до упора и обратно.

ШАГ 7

## Натри паз ящика парафином

Ящик висит на бортике, который лежит на скосе 45°. ABS по ABS со временем скрипит и стирается, особенно в слое 0.28. Пару раз проведи свечкой по скосу в обеих опорах, и ящик пойдёт мягко. Масло не нужно, на нём собирается пыль.

ШАГ 8

## Резиновая лента под ноги и метки на прутках

- Лента под ноги. Четыре опоры на одной раме и чуть повело ABS, вот и качание. Лента выравнивает и не даёт полке уехать, когда тянешь ящик.
- Метки. Когда всё выставлено и ящики ходят, обведи карандашом внутренние опоры на 1-м и 5-м прутке. Следующая сборка — без бруска, по меткам.

Если полка качается вбок, когда толкаешь монитор, можно натянуть сзади два тросика крест-накрест в центральном пролёте. Это на потом, если понадобится.

DeskShelf v2.4b · внутренние опоры: гнёзда 20.2 / 19.3 / 20.4 / 19.3 / 20.2 (спереди назад) · отсек 194 мм
