myratmyradov1997/dowel-desk-shelf/(commit log)

2026-10-20 Dowel desk shelf: models, CAD, generators, print profiles and docs
    Shelf v2.4c (five 20 mm dowels), modules, MagSafe mount v3 and accessories
    (Gridfinity, front-rod holders, storage, ESP32 backlight).
    [acc_backlight.f3d, acc_backlight_box.stl, acc_backlight_box_lid.stl, acc_backlight_bracket_L.stl, acc_backlight_bracket_R.stl, acc_backlight_diffuser_S1.stl, acc_backlight_diffuser_S2.stl, acc_backlight_diffuser_S3.stl]
2026-10-20 Add all-in-one Fusion assembly (shelf, modules, MagSafe, accessories)
    [all_in_one.f3d]
2026-10-23 Orca profiles: lower the bed at the end of a print
    [machine.json]
2026-10-23 v2.5c: drawer stop tongue rooted in the floor, wrap-around deck tiles (experimental), real photos
    - Drawer stop tongue grows up from the floor: two vertical 1 mm slots, a 45 deg pointed top
    under a 45 deg arch, nub moved 12 mm up to stay near the free end. The v2.4c tongue ran
    between horizontal slots and printed 43 mm bridges in mid-air on the first drawer. A
    per-layer support check of the G-code finds no bridges and no plastic starting over air.
    - Wrap-around deck tiles v2.5 (front hooks + back snap rings), test print pending.
    - Photos of the real build, G-code comparison, updated status and known issues.
    [deck_tile_wrap_v2.5.stl, drawer_left.stl, drawer_right.stl, shelf_v2_5c.f3d, shelf_v2_5c_solids.step]
